kjpeng/ingestible-capsule/IngestibleCapsule-Board_larger_vias/IngestibleCapsule-Board_larger_vias.jpg

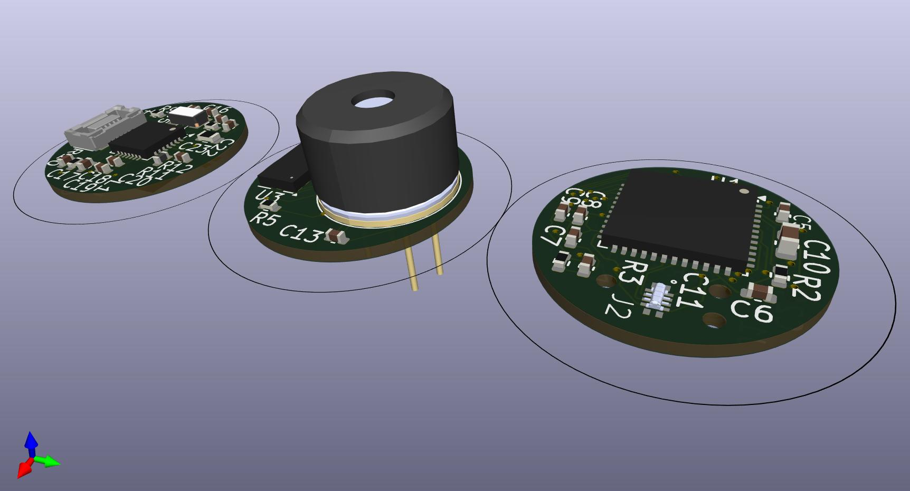
IngestibleCapsule-Board_larger_vias/IngestibleCapsule-Board_larger_vias.jpg
