kjpeng/ingestible-capsule/IngestibleCapsule-Board_v2/IngestibleCapsule-Drawing_v2.SLDPRT

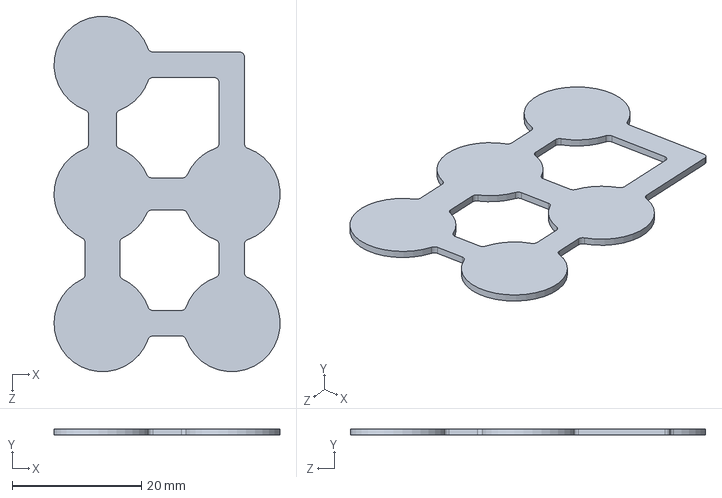
[picture p2: CAD file, 2025-04-11]
IngestibleCapsule-Board_v2/IngestibleCapsule-Drawing_v2.SLDPRT
35.0 x 1.00 x 54.9 mm
