kjpeng/ingestible-capsule/(list of files, cad)

Other CAD files:
IngestibleCapsule-Board_v2/IngestibleCapsule-Drawing_v2.DXF
