kjpeng/ingestible-capsule/IngestibleCapsule-Board_v2/IngestibleCapsule-Board_v2.kicad_pcb

## KiCad design IngestibleCapsule-Board_v2/IngestibleCapsule-Board_v2.kicad_pcb (2025-04-24)

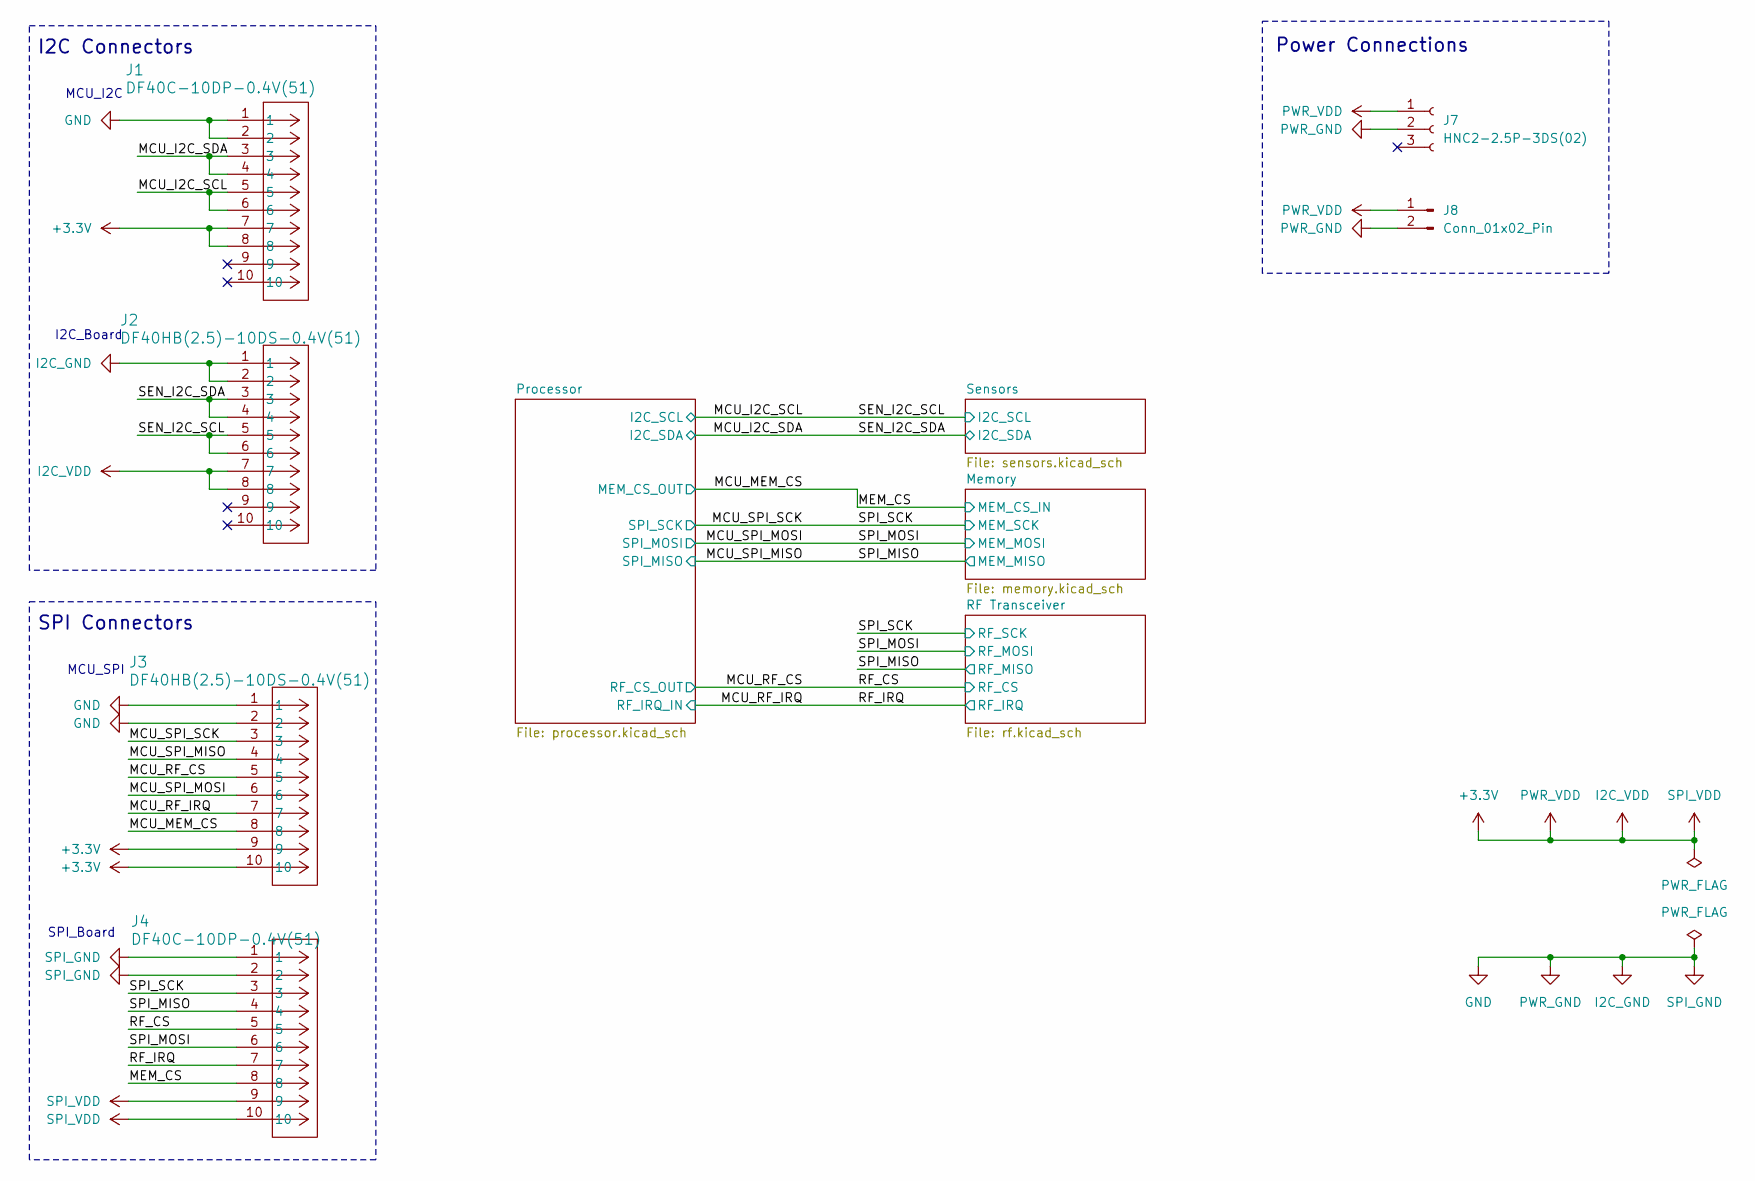
[picture p8: schematic IngestibleCapsule-Board_v2.kicad_sch, Ingestible Capsule]

Parts:
J1, J4: DF40C-10DP-0.4V(51)
J2, J3: DF40HB(2.5)-10DS-0.4V(51)
J7: HNC2-2.5P-3DS(02)
J8: Conn_01x02_Pin; PinSocket_1x02_P2.54mm_Vertical

Connections:
+3.3V: J1.7, J1.8, J2.7, J2.8, J3.9, J3.10, J4.9, J4.10, J7.1, J8.1; also elsewhere on the board
/MCU_I2C_SCL: J1.5, J1.6, J2.5, J2.6; also elsewhere on the board
/MCU_I2C_SDA: J1.3, J1.4, J2.3, J2.4; also elsewhere on the board
/MCU_MEM_CS: J3.8, J4.8; also elsewhere on the board
/MCU_RF_CS: J3.5, J4.5; also elsewhere on the board
/MCU_RF_IRQ: J3.7, J4.7; also elsewhere on the board
/MCU_SPI_MISO: J3.4, J4.4; also elsewhere on the board
/MCU_SPI_MOSI: J3.6, J4.6; also elsewhere on the board
/MCU_SPI_SCK: J3.3, J4.3; also elsewhere on the board
GND: J1.1, J1.2, J2.1, J2.2, J3.1, J3.2, J4.1, J4.2, J7.2, J8.2; also elsewhere on the board

Notes on the sheet:
MCU_I2C
I2C_Board
MCU_SPI
SPI_Board
SPI Connectors
I2C Connectors
Power Connections

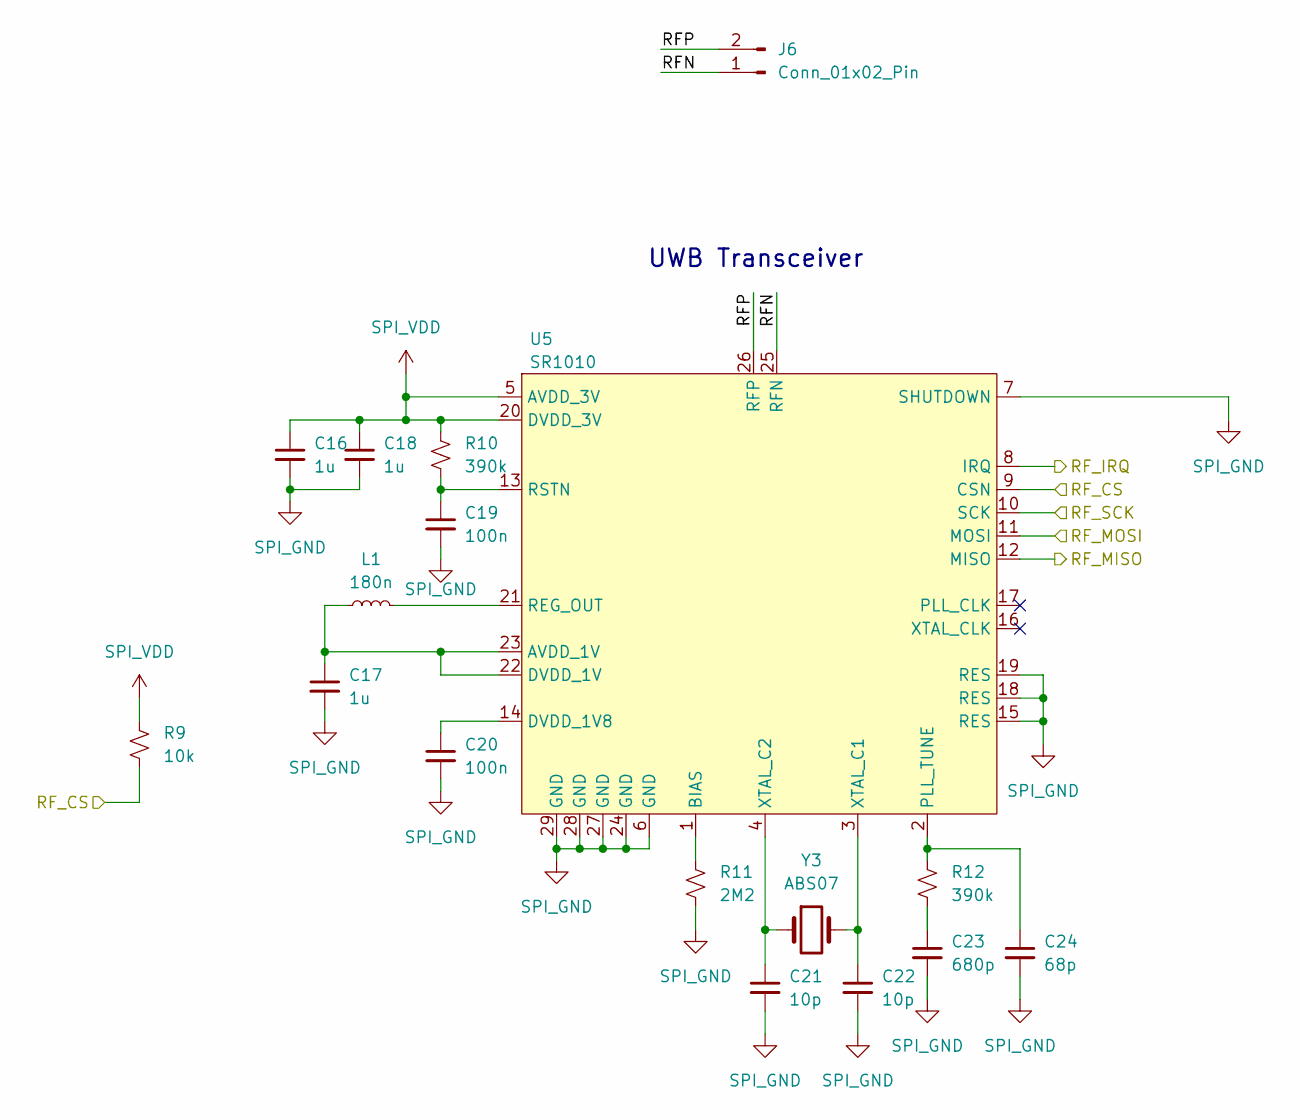
[picture p9: schematic rf.kicad_sch, RF Transceiver]

Parts:
C16, C17, C18: 1u; C_0402_1005Metric
C19, C20: 100n; C_0402_1005Metric
C21, C22: 10p; C_0402_1005Metric
C23: 680p; C_0402_1005Metric
C24: 68p; C_0402_1005Metric
J6: Conn_01x02_Pin; BM02BSRSSTBLFSN
L1: 180n; L_0402_1005Metric
R9: 10k; R_0402_1005Metric
R10, R12: 390k; R_0402_1005Metric
R11: 2M2; R_0603_1608Metric
U5: SR1010
Y3: ABS07; ABS07-120-32.768KHZ-T

Connections:
+3.3V: C16.1, C18.1, R9.1, R10.1, U5.5 (AVDD_3V), U5.20 (DVDD_3V); also elsewhere on the board
/MCU_RF_CS: R9.2, U5.9 (CSN); also elsewhere on the board
/MCU_RF_IRQ: U5.8 (IRQ); also elsewhere on the board
/MCU_SPI_MISO: U5.12 (MISO); also elsewhere on the board
/MCU_SPI_MOSI: U5.11 (MOSI); also elsewhere on the board
/MCU_SPI_SCK: U5.10 (SCK); also elsewhere on the board
/RF Transceiver/RFN: J6.1, U5.25 (RFN)
/RF Transceiver/RFP: J6.2, U5.26 (RFP)
GND: C16.2, C17.2, C18.2, C19.2, C20.2, C21.2, C22.2, C23.2, C24.2, R11.2, U5.6 (GND), U5.7 (SHUTDOWN), U5.15 (RES), U5.18 (RES), U5.19 (RES), U5.24 (GND), U5.27 (GND), U5.28 (GND), U5.29 (GND); also elsewhere on the board
unnamed: C23.1, R12.2
unnamed: C17.1, L1.1, U5.22 (DVDD_1V), U5.23 (AVDD_1V)
unnamed: R11.1, U5.1 (BIAS)
unnamed: C20.1, U5.14 (DVDD_1V8)
unnamed: C24.1, R12.1, U5.2 (PLL_TUNE)
unnamed: L1.2, U5.21 (REG_OUT)
unnamed: C19.1, R10.2, U5.13 (RSTN)
unnamed: C22.1, U5.3 (XTAL_C1), Y3.2
unnamed: C21.1, U5.4 (XTAL_C2), Y3.1

Notes on the sheet:
UWB Transceiver

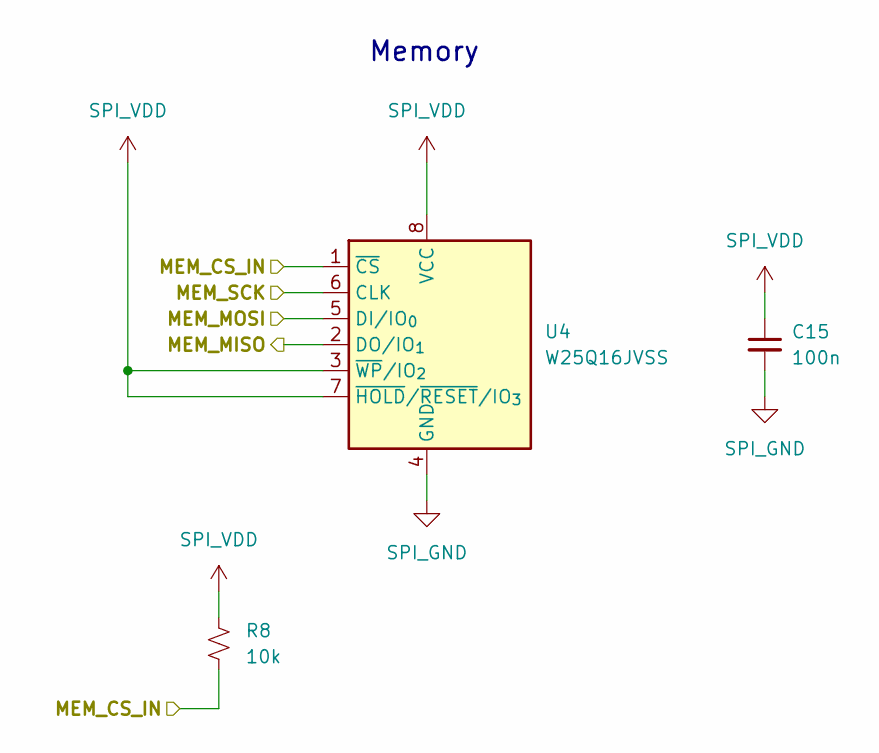
[picture p10: schematic memory.kicad_sch]

Parts:
C15: 100n; C_0402_1005Metric
R8: 10k; R_0402_1005Metric
U4: W25Q16JVSS; SOIC-8_5.3x5.3mm_P1.27mm

Connections:
+3.3V: C15.1, R8.1, U4.3 (~WP/IO_{2}), U4.7 (~HOLD/~RESET/IO_{3}), U4.8 (VCC); also elsewhere on the board
/MCU_MEM_CS: R8.2, U4.1 (~CS); also elsewhere on the board
/MCU_SPI_MISO: U4.2 (DO/IO_{1}); also elsewhere on the board
/MCU_SPI_MOSI: U4.5 (DI/IO_{0}); also elsewhere on the board
/MCU_SPI_SCK: U4.6 (CLK); also elsewhere on the board
GND: C15.2, U4.4 (GND); also elsewhere on the board

Notes on the sheet:
Memory

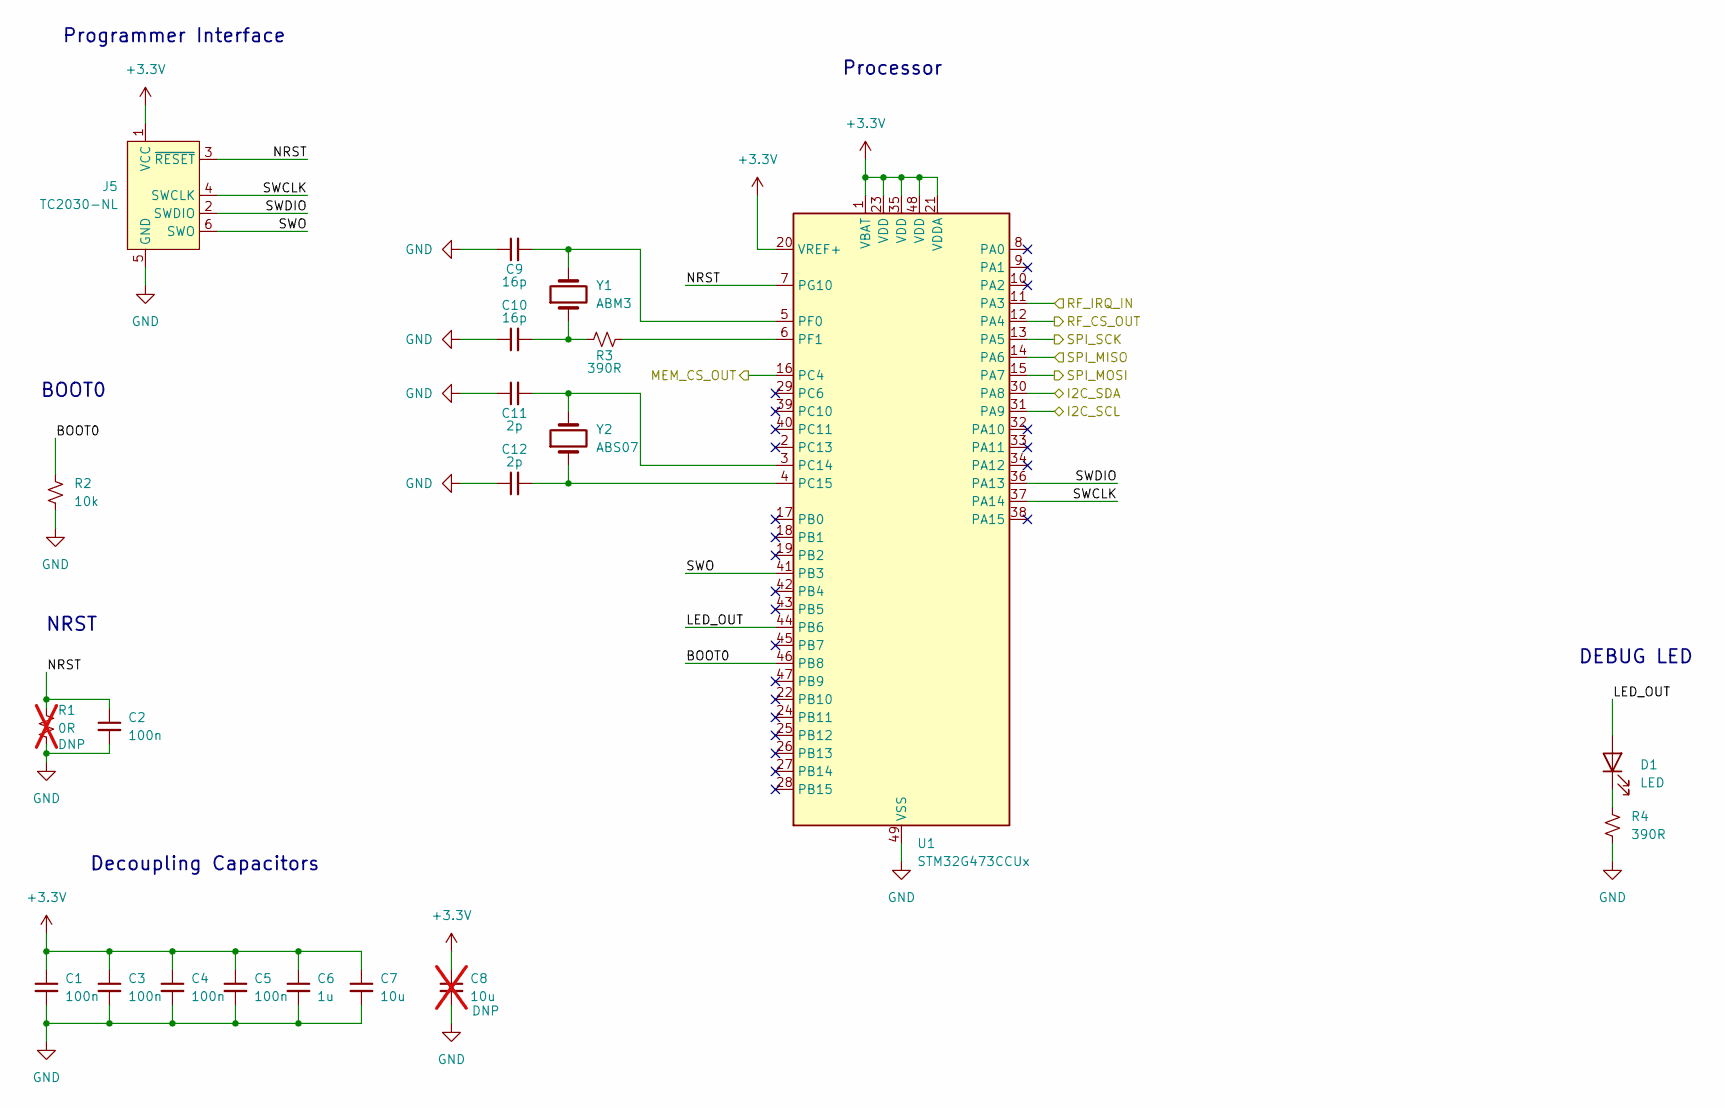
[picture p11: schematic processor.kicad_sch]

Parts:
C1, C2, C3, C4, C5: 100n; C_0402_1005Metric
C6: 1u; C_0402_1005Metric
C7: 10u; C_0603_1608Metric
C8: 10u; C_0603_1608Metric; not fitted
C9, C10: 16p; C_0402_1005Metric
C11, C12: 2p; C_0402_1005Metric
D1: LED; LED_0402_1005Metric
J5: TC2030-NL; Tag-Connect_TC2030-IDC-NL_2x03_P1.27mm_Vertical
R1: 0R; R_0402_1005Metric; not fitted
R2: 10k; R_0402_1005Metric
R3, R4: 390R; R_0402_1005Metric
U1: STM32G473CCUx; QFN-48-1EP_7x7mm_P0.5mm_EP5.6x5.6mm
Y1: ABM3; ABM3-48.000MHZ-B2-T
Y2: ABS07; ABS07-120-32.768KHZ-T

Connections:
+3.3V: C1.1, C3.1, C4.1, C5.1, C6.1, C7.1, C8.1, J5.1 (VCC), U1.1 (VBAT), U1.20 (VREF+), U1.21 (VDDA), U1.23 (VDD), U1.35 (VDD), U1.48 (VDD); also elsewhere on the board
/MCU_I2C_SCL: U1.31 (PA9); also elsewhere on the board
/MCU_I2C_SDA: U1.30 (PA8); also elsewhere on the board
/MCU_MEM_CS: U1.16 (PC4); also elsewhere on the board
/MCU_RF_CS: U1.12 (PA4); also elsewhere on the board
/MCU_RF_IRQ: U1.11 (PA3); also elsewhere on the board
/MCU_SPI_MISO: U1.14 (PA6); also elsewhere on the board
/MCU_SPI_MOSI: U1.15 (PA7); also elsewhere on the board
/MCU_SPI_SCK: U1.13 (PA5); also elsewhere on the board
/Processor/BOOT0: R2.1, U1.46 (PB8)
/Processor/LED_OUT: D1.2 (A), U1.44 (PB6)
/Processor/NRST: C2.1, J5.3 (~RESET), R1.1, U1.7 (PG10)
/Processor/SWCLK: J5.4 (SWCLK), U1.37 (PA14)
/Processor/SWDIO: J5.2 (SWDIO), U1.36 (PA13)
/Processor/SWO: J5.6 (SWO), U1.41 (PB3)
GND: C1.2, C2.2, C3.2, C4.2, C5.2, C6.2, C7.2, C8.2, C9.1, C10.1, C11.1, C12.1, J5.5 (GND), R1.2, R2.2, R4.2, U1.49 (VSS); also elsewhere on the board
unnamed: C10.2, R3.1, Y1.1
unnamed: D1.1 (K), R4.1
unnamed: C11.2, U1.3 (PC14), Y2.2
unnamed: C12.2, U1.4 (PC15), Y2.1
unnamed: C9.2, U1.5 (PF0), Y1.2
unnamed: R3.2, U1.6 (PF1)

Notes on the sheet:
Programmer Interface
Decoupling Capacitors
BOOT0
NRST
Processor
DEBUG LED

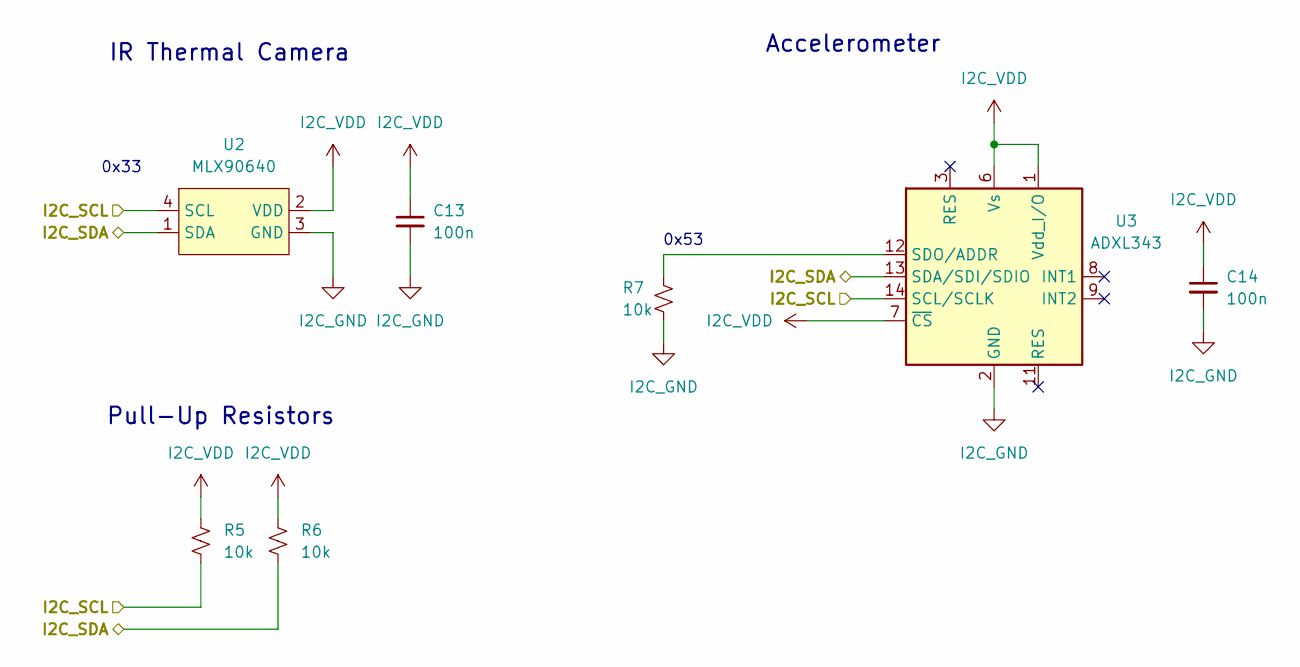
[picture p12: schematic sensors.kicad_sch]

Parts:
C13, C14: 100n; C_0402_1005Metric
R5, R6, R7: 10k; R_0402_1005Metric
U2: MLX90640
U3: ADXL343; LGA-14_3x5mm_P0.8mm_LayoutBorder1x6y

Connections:
+3.3V: C13.1, C14.1, R5.1, R6.1, U2.2 (VDD), U3.1 (Vdd_I/O), U3.6 (Vs), U3.7 (~CS); also elsewhere on the board
/MCU_I2C_SCL: R5.2, U2.4 (SCL), U3.14 (SCL/SCLK); also elsewhere on the board
/MCU_I2C_SDA: R6.2, U2.1 (SDA), U3.13 (SDA/SDI/SDIO); also elsewhere on the board
GND: C13.2, C14.2, R7.1, U2.3 (GND), U3.2 (GND), U3.4 (GND), U3.5 (GND); also elsewhere on the board
unnamed: R7.2, U3.12 (SDO/ADDR)

Notes on the sheet:
0x53
IR Thermal Camera
Accelerometer
0x33
Pull-Up Resistors

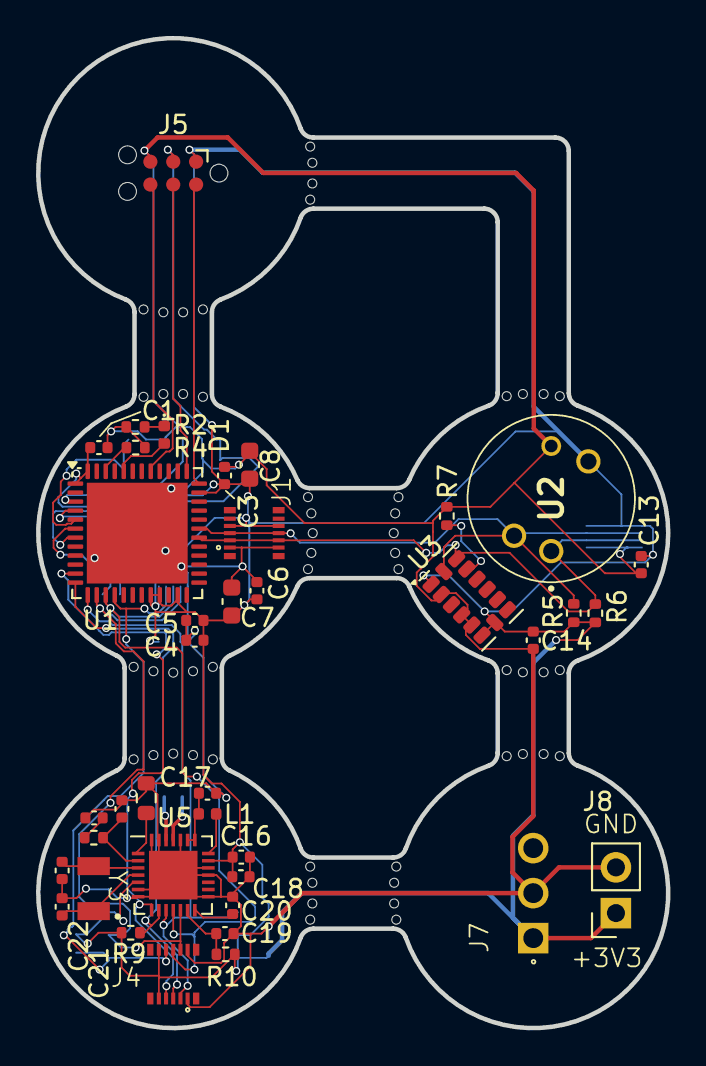
[picture p13: board IngestibleCapsule-Board_v2.kicad_pcb from above]

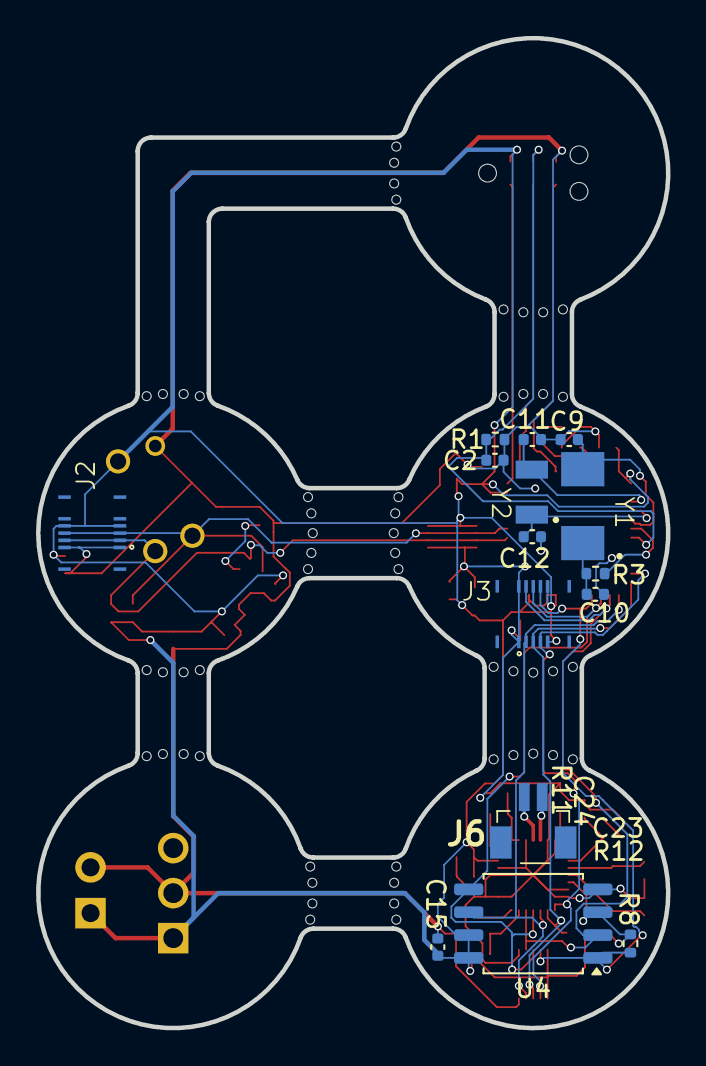
[picture p14: board IngestibleCapsule-Board_v2.kicad_pcb from below]

Board: 2 copper layers, 35.0 x 55.0 mm, 66 parts (15 on the bottom side), 34 nets.

Other parts of the board:
i2c_2_2, i2c_2_2#2: VAL**; i2c_2_2
prog_3_2, prog_3_2#2: VAL**; prog_3_2
pwr_4_2, pwr_4_2#2, pwr_4_2#3, pwr_4_2#4, pwr_4_2#5, pwr_4_2#6: VAL**; pwr_4_2
spi_4_2, spi_4_2#2: VAL**; spi_4_2
