kjpeng/ingestible-capsule/IngestibleCapsule-Board_whole/IngestibleCapsule-Board_whole.kicad_pcb

## KiCad design IngestibleCapsule-Board_whole/IngestibleCapsule-Board_whole.kicad_pcb (2025-04-24)

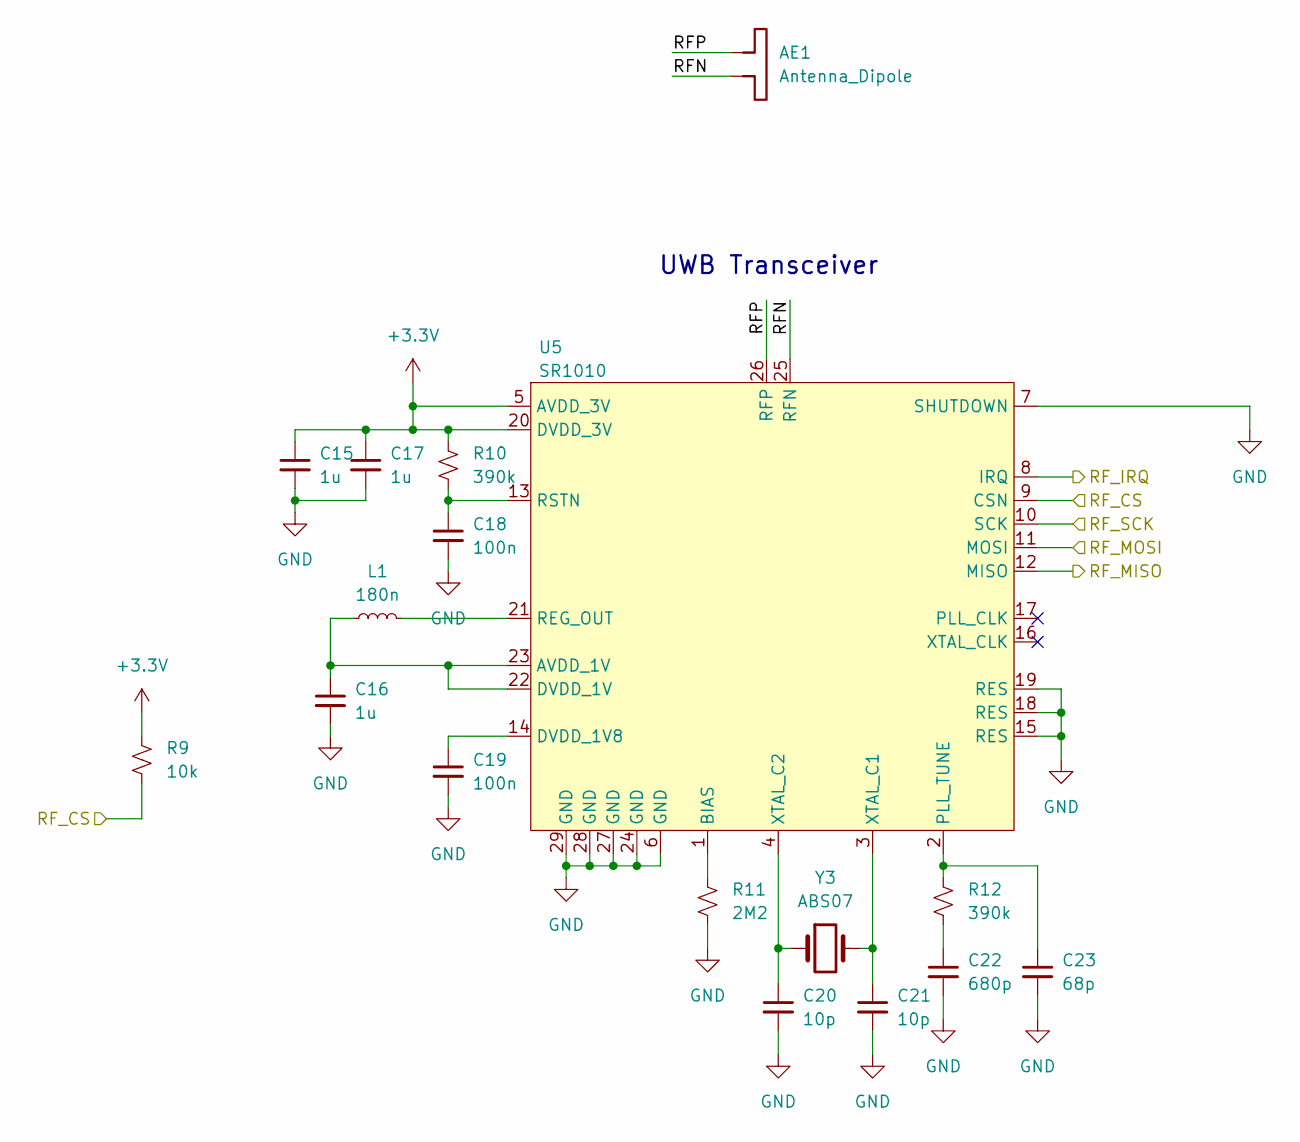
[picture p15: schematic rf.kicad_sch, RF Transceiver]

Parts:
AE1: Antenna_Dipole; Dipole Antenna
C15, C16, C17: 1u; C_0402_1005Metric
C18, C19: 100n; C_0402_1005Metric
C20, C21: 10p; C_0402_1005Metric
C22: 680p; C_0402_1005Metric
C23: 68p; C_0402_1005Metric
L1: 180n; L_0402_1005Metric
R9: 10k; R_0402_1005Metric
R10, R12: 390k; R_0402_1005Metric
R11: 2M2; R_0603_1608Metric
U5: SR1010; QFN-28-1EP_4x4mm_P0.4mm_EP2.7x2.7mm
Y3: ABS07; ABS07-120-32.768KHZ-T

Connections:
+3.3V: C15.1, C17.1, R9.1, R10.1, U5.5 (AVDD_3V), U5.20 (DVDD_3V); also elsewhere on the board
/Memory/MEM_MISO: U5.12 (MISO); also elsewhere on the board
/Memory/MEM_MOSI: U5.11 (MOSI); also elsewhere on the board
/Memory/MEM_SCK: U5.10 (SCK); also elsewhere on the board
/Processor/RF_CS_OUT: R9.2, U5.9 (CSN); also elsewhere on the board
/Processor/RF_IRQ_IN: U5.8 (IRQ); also elsewhere on the board
/RF Transceiver/RFN: AE1.2, U5.25 (RFN)
/RF Transceiver/RFP: AE1.1, U5.26 (RFP)
GND: C15.2, C16.2, C17.2, C18.2, C19.2, C20.2, C21.2, C22.2, C23.2, R11.2, U5.6 (GND), U5.7 (SHUTDOWN), U5.15 (RES), U5.18 (RES), U5.19 (RES), U5.24 (GND), U5.27 (GND), U5.28 (GND), U5.29 (GND); also elsewhere on the board
unnamed: C22.1, R12.2
unnamed: C16.1, L1.1, U5.22 (DVDD_1V), U5.23 (AVDD_1V)
unnamed: R11.1, U5.1 (BIAS)
unnamed: C19.1, U5.14 (DVDD_1V8)
unnamed: C23.1, R12.1, U5.2 (PLL_TUNE)
unnamed: L1.2, U5.21 (REG_OUT)
unnamed: C18.1, R10.2, U5.13 (RSTN)
unnamed: C21.1, U5.3 (XTAL_C1), Y3.2
unnamed: C20.1, U5.4 (XTAL_C2), Y3.1

Notes on the sheet:
UWB Transceiver

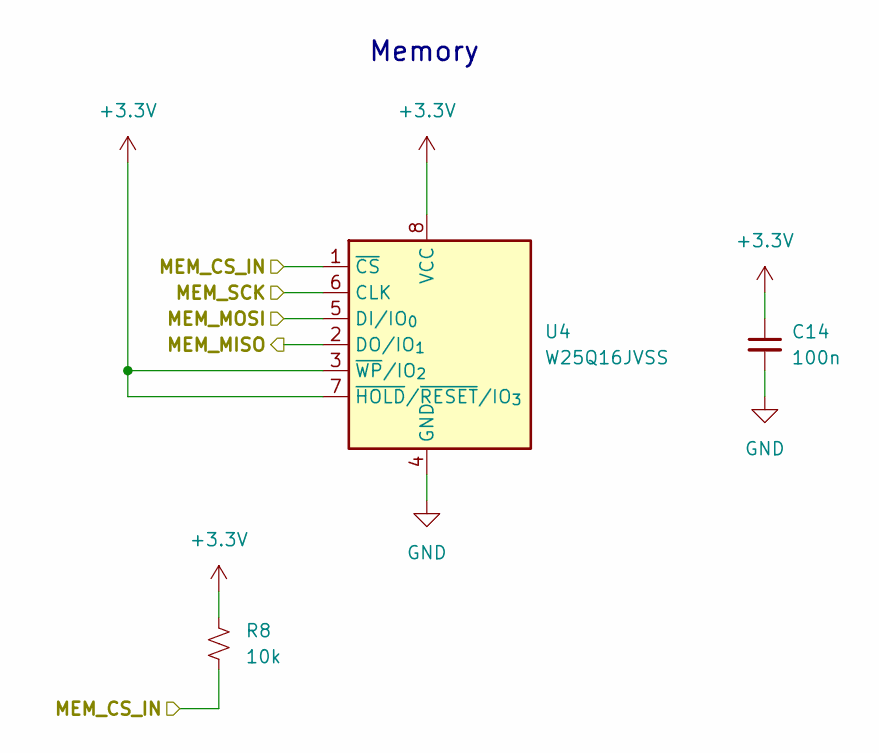
[picture p16: schematic memory.kicad_sch]

Parts:
C14: 100n; C_0402_1005Metric
R8: 10k; R_0402_1005Metric
U4: W25Q16JVSS; SOIC-8_5.3x5.3mm_P1.27mm

Connections:
+3.3V: C14.1, R8.1, U4.3 (~WP/IO_{2}), U4.7 (~HOLD/~RESET/IO_{3}), U4.8 (VCC); also elsewhere on the board
/Memory/MEM_CS_IN: R8.2, U4.1 (~CS); also elsewhere on the board
/Memory/MEM_MISO: U4.2 (DO/IO_{1}); also elsewhere on the board
/Memory/MEM_MOSI: U4.5 (DI/IO_{0}); also elsewhere on the board
/Memory/MEM_SCK: U4.6 (CLK); also elsewhere on the board
GND: C14.2, U4.4 (GND); also elsewhere on the board

Notes on the sheet:
Memory

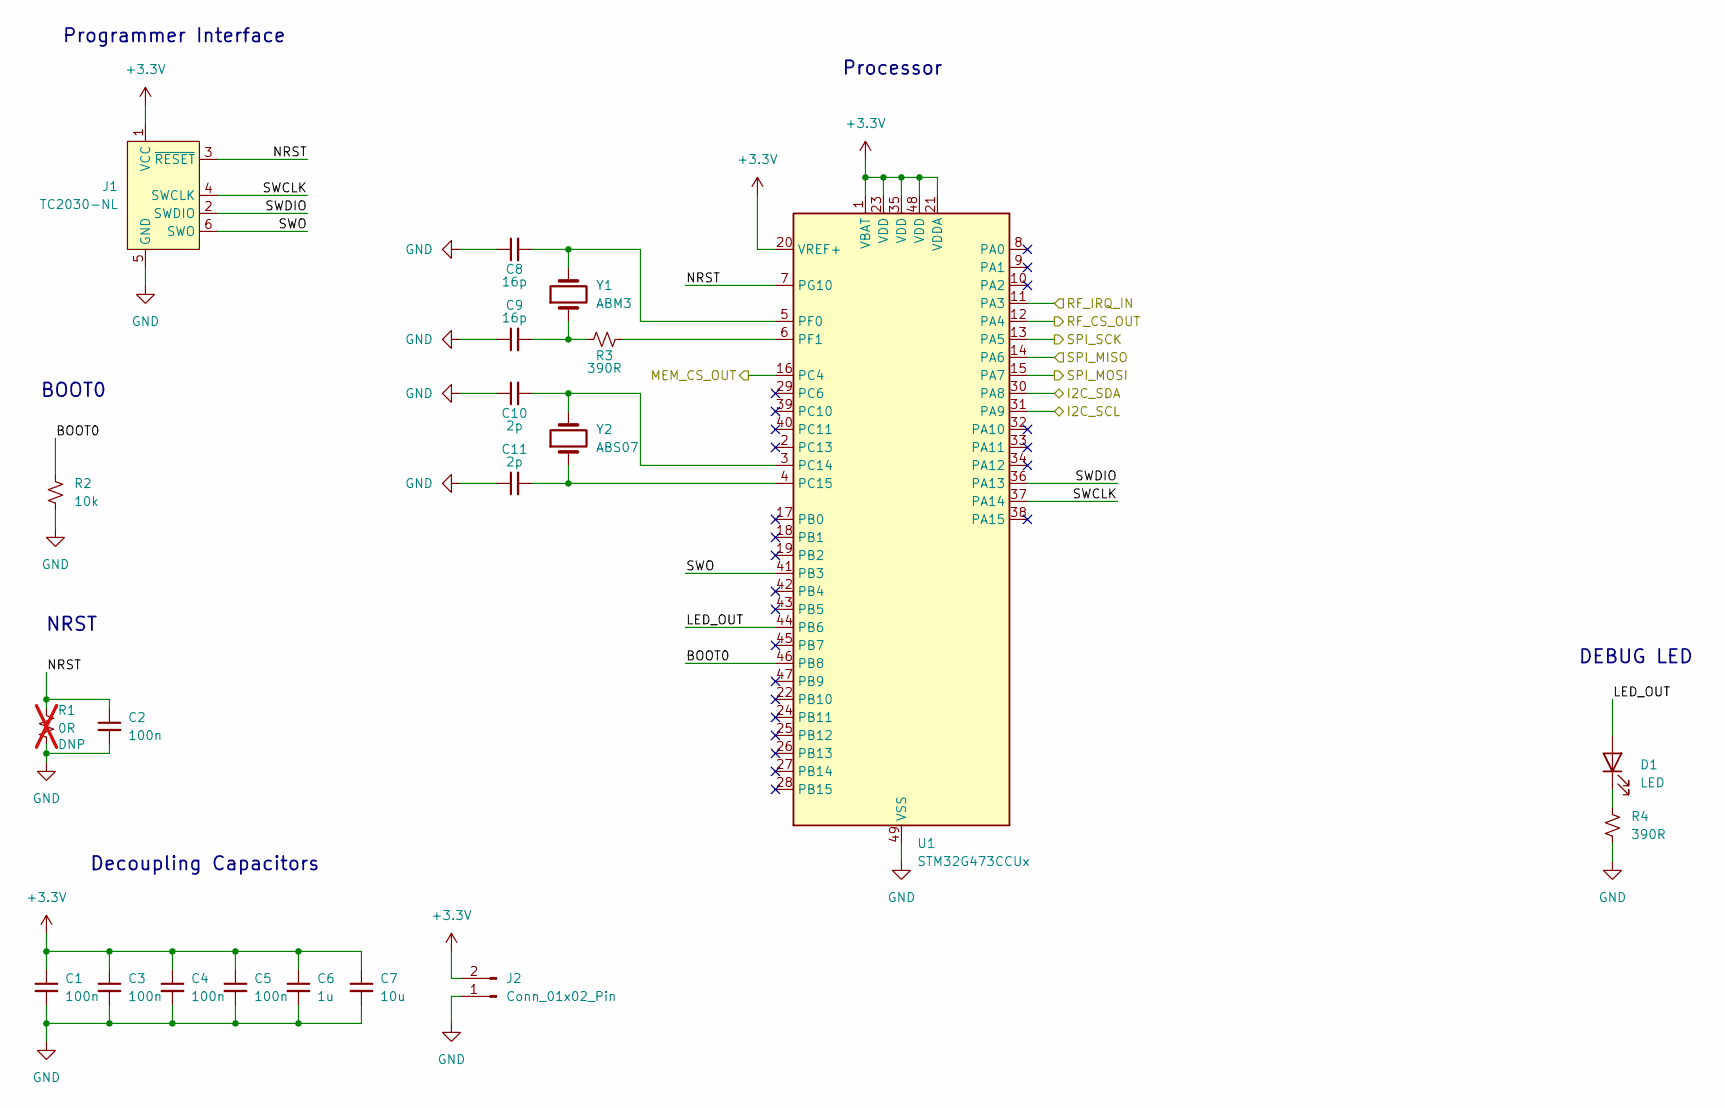
[picture p17: schematic processor.kicad_sch]

Parts:
C1, C2, C3, C4, C5: 100n; C_0402_1005Metric
C6: 1u; C_0402_1005Metric
C7: 10u; C_0603_1608Metric
C8, C9: 16p; C_0402_1005Metric
C10, C11: 2p; C_0402_1005Metric
D1: LED; LED_0402_1005Metric
J1: TC2030-NL; Tag-Connect_TC2030-IDC-NL_2x03_P1.27mm_Vertical
J2: Conn_01x02_Pin; PinHeader_1x02_P2.54mm_Vertical
R1: 0R; R_0402_1005Metric; not fitted
R2: 10k; R_0402_1005Metric
R3, R4: 390R; R_0402_1005Metric
U1: STM32G473CCUx; QFN-48-1EP_7x7mm_P0.5mm_EP5.6x5.6mm
Y1: ABM3; ABM3-48.000MHZ-B2-T
Y2: ABS07; ABS07-120-32.768KHZ-T

Connections:
+3.3V: C1.1, C3.1, C4.1, C5.1, C6.1, C7.1, J1.1 (VCC), J2.2, U1.1 (VBAT), U1.20 (VREF+), U1.21 (VDDA), U1.23 (VDD), U1.35 (VDD), U1.48 (VDD); also elsewhere on the board
/Memory/MEM_CS_IN: U1.16 (PC4); also elsewhere on the board
/Memory/MEM_MISO: U1.14 (PA6); also elsewhere on the board
/Memory/MEM_MOSI: U1.15 (PA7); also elsewhere on the board
/Memory/MEM_SCK: U1.13 (PA5); also elsewhere on the board
/Processor/BOOT0: R2.1, U1.46 (PB8)
/Processor/I2C_SCL: U1.31 (PA9); also elsewhere on the board
/Processor/I2C_SDA: U1.30 (PA8); also elsewhere on the board
/Processor/LED_OUT: D1.2 (A), U1.44 (PB6)
/Processor/NRST: C2.1, J1.3 (~RESET), R1.1, U1.7 (PG10)
/Processor/RF_CS_OUT: U1.12 (PA4); also elsewhere on the board
/Processor/RF_IRQ_IN: U1.11 (PA3); also elsewhere on the board
/Processor/SWCLK: J1.4 (SWCLK), U1.37 (PA14)
/Processor/SWDIO: J1.2 (SWDIO), U1.36 (PA13)
/Processor/SWO: J1.6 (SWO), U1.41 (PB3)
GND: C1.2, C2.2, C3.2, C4.2, C5.2, C6.2, C7.2, C8.1, C9.1, C10.1, C11.1, J1.5 (GND), J2.1, R1.2, R2.2, R4.2, U1.49 (VSS); also elsewhere on the board
unnamed: C9.2, R3.1, Y1.1
unnamed: D1.1 (K), R4.1
unnamed: C10.2, U1.3 (PC14), Y2.2
unnamed: C11.2, U1.4 (PC15), Y2.1
unnamed: C8.2, U1.5 (PF0), Y1.2
unnamed: R3.2, U1.6 (PF1)

Notes on the sheet:
Programmer Interface
Decoupling Capacitors
BOOT0
NRST
Processor
DEBUG LED

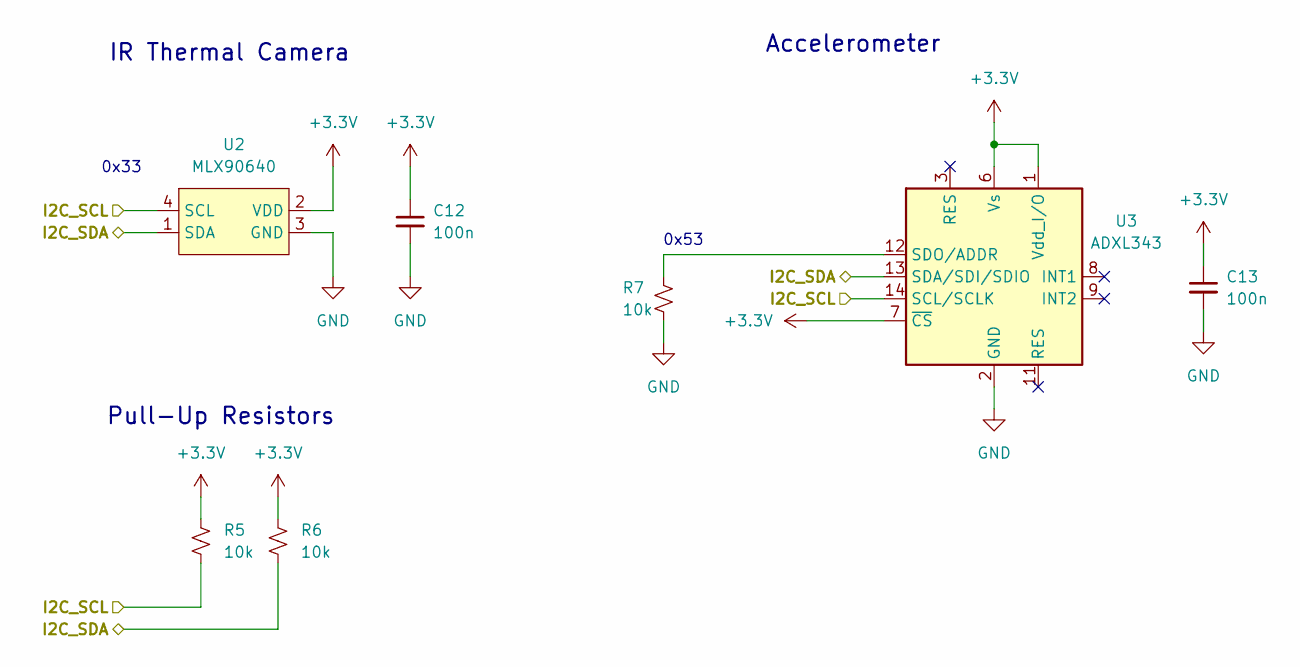
[picture p18: schematic sensors.kicad_sch]

Parts:
C12, C13: 100n; C_0402_1005Metric
R5, R6, R7: 10k; R_0402_1005Metric
U2: MLX90640
U3: ADXL343; LGA-14_3x5mm_P0.8mm_LayoutBorder1x6y

Connections:
+3.3V: C12.1, C13.1, R5.1, R6.1, U2.2 (VDD), U3.1 (Vdd_I/O), U3.6 (Vs), U3.7 (~CS); also elsewhere on the board
/Processor/I2C_SCL: R5.2, U2.4 (SCL), U3.14 (SCL/SCLK); also elsewhere on the board
/Processor/I2C_SDA: R6.2, U2.1 (SDA), U3.13 (SDA/SDI/SDIO); also elsewhere on the board
GND: C12.2, C13.2, R7.1, U2.3 (GND), U3.2 (GND), U3.4 (GND), U3.5 (GND); also elsewhere on the board
unnamed: R7.2, U3.12 (SDO/ADDR)

Notes on the sheet:
0x53
IR Thermal Camera
Accelerometer
0x33
Pull-Up Resistors

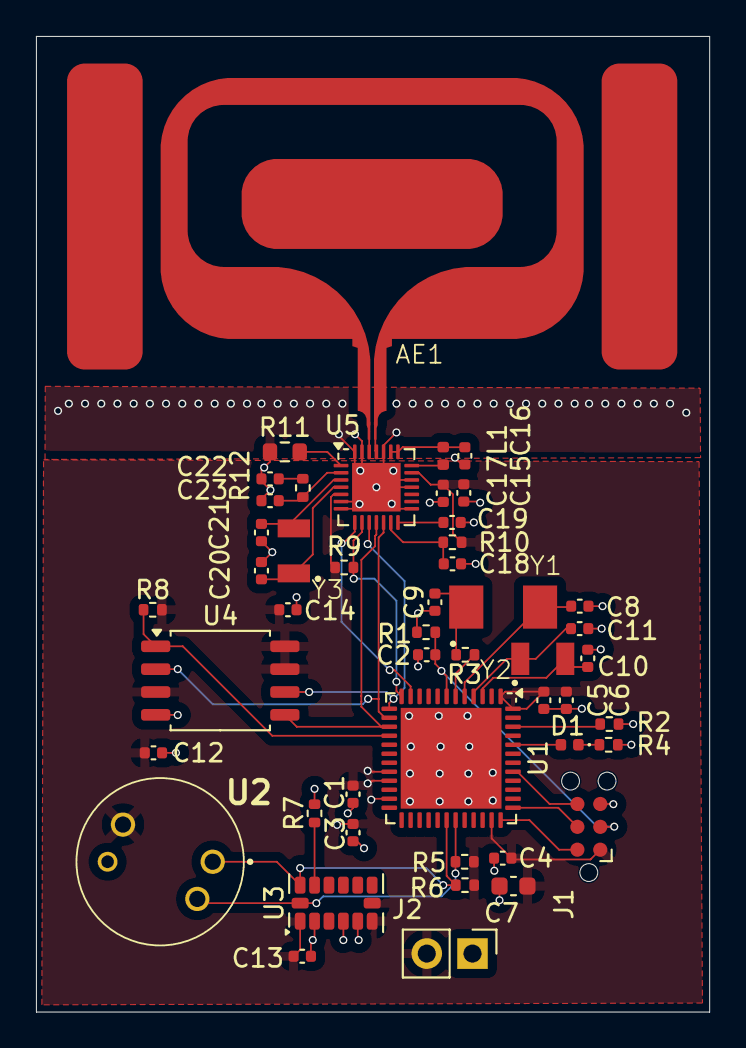
[picture p19: board IngestibleCapsule-Board_whole.kicad_pcb from above]

Board: 2 copper layers, 37.4 x 54.2 mm, 48 parts (0 on the bottom side), 34 nets.
