kjpeng/ingestible-capsule/IngestibleCapsule-Antennae/IngestibleCapsule-Antennae.kicad_pcb

## KiCad design IngestibleCapsule-Antennae/IngestibleCapsule-Antennae.kicad_pcb (2025-04-01)

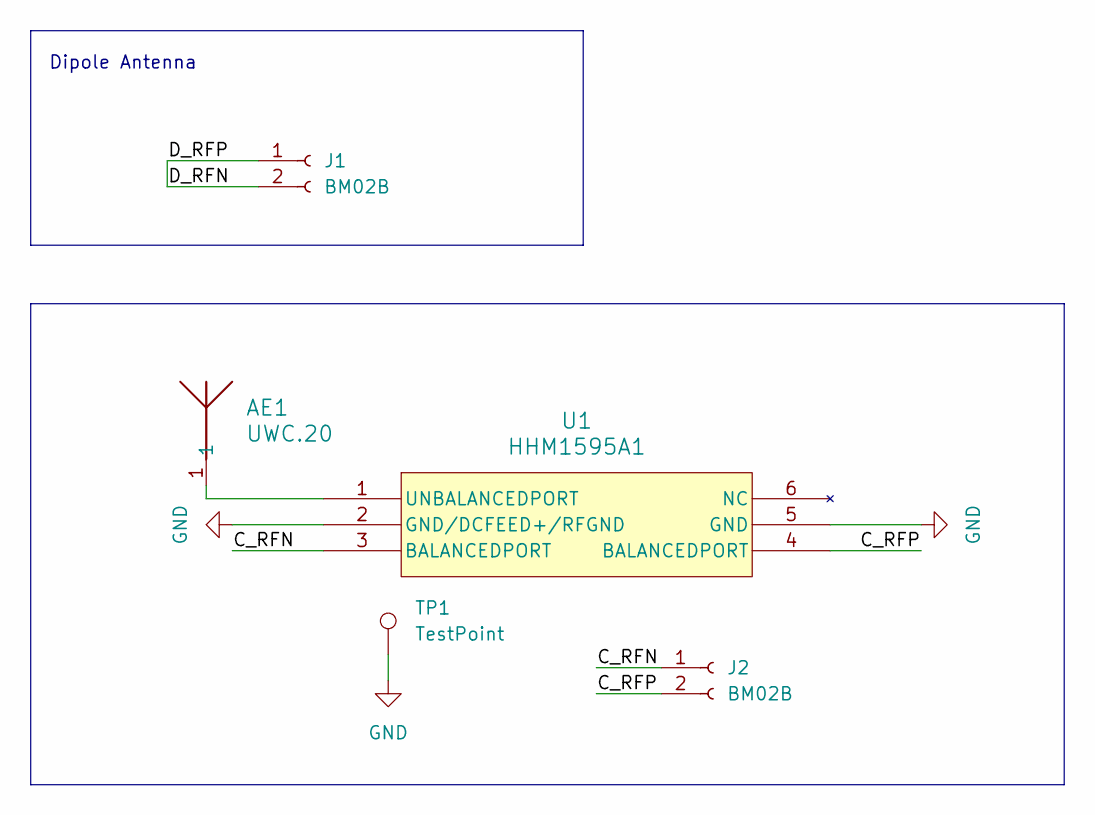
[picture p20: schematic IngestibleCapsule-Antennae.kicad_sch]

Parts:
AE1: UWC.20; ANT_SMD6_UWC_TAL
J1, J2: BM02B; BM02BSRSSTBLFSN
TP1: TestPoint; TestPoint_Pad_2.0x2.0mm
U1: HHM1595A1; HHM-6_2P0X1P25

Connections:
/C_RFN: J2.1, U1.3 (BALANCEDPORT)
/C_RFP: J2.2, U1.4 (BALANCEDPORT)
/D_RFN: J1.1, J1.2
GND: TP1.1, U1.2 (GND/DCFEED+/RFGND), U1.5 (GND)
unnamed: AE1.1, U1.1 (UNBALANCEDPORT)

Notes on the sheet:
Dipole Antenna

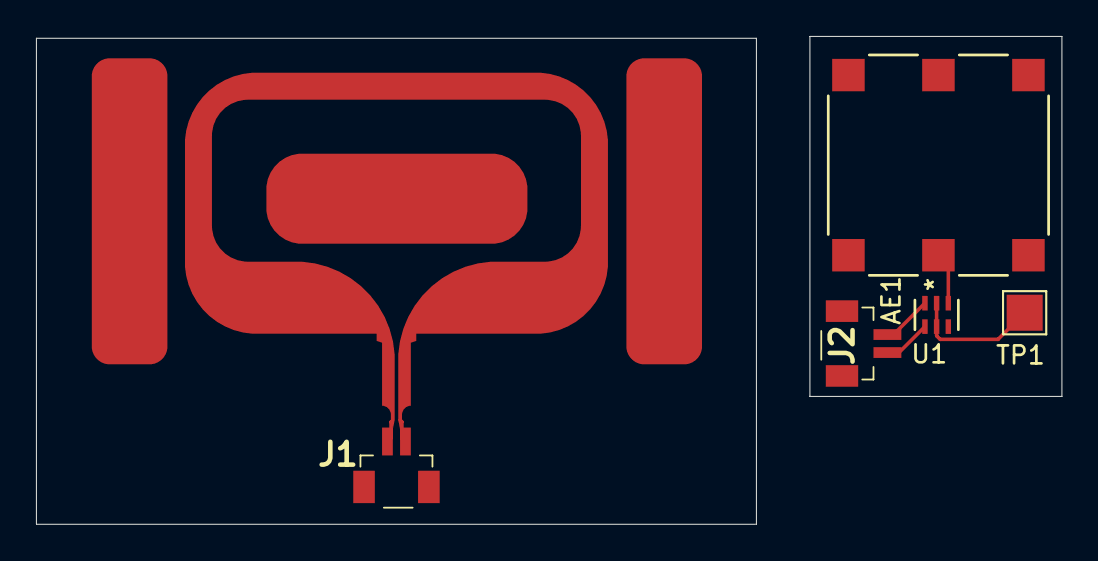
[picture p21: board IngestibleCapsule-Antennae.kicad_pcb from above]

Board: 2 copper layers, 57.0 x 27.1 mm, 5 parts (0 on the bottom side), 5 nets.
