kjpeng/ingestible-capsule/IngestibleCapsule-CubeMX/IngestibleCapsule-CubeMX.ioc

Mcu.UserName=STM32G473CCUx
PA11.Signal=GPIO_Input
PA13.Signal=SYS_JTMS-SWDIO
PA14.Signal=SYS_JTCK-SWCLK
PA3.GPIO_Label=RF_IRQ_IN
PA3.Signal=GPIO_Input
PA4.GPIO_Label=RF_CS_OUT
PA4.Signal=GPIO_Output
PA5.Signal=SPI1_SCK
PA6.Signal=SPI1_MISO
PA7.Signal=SPI1_MOSI
PA8.Signal=I2C2_SDA
PA9.Signal=I2C2_SCL
PB10.Signal=GPIO_Input
PB3.Signal=SYS_JTDO-SWO
PB6.GPIO_Label=LED_OUT
PB6.Signal=GPIO_Output
PB9.Signal=GPIO_Input
PC14-OSC32_IN.Signal=RCC_OSC32_IN
PC15-OSC32_OUT.Signal=RCC_OSC32_OUT
PC4.GPIO_Label=MEM_CS_OUT
PC4.Signal=GPIO_Output
PF0-OSC_IN.Signal=RCC_OSC_IN
PF1-OSC_OUT.Signal=RCC_OSC_OUT
