kjpeng/ingestible-capsule/BoardWhole-CubeMX/Core/Inc/main.h

#define RAD_IRQ_Pin GPIO_PIN_3
#define RAD_IRQ_GPIO_Port GPIOA
#define RAD_CS_Pin GPIO_PIN_4
#define RAD_CS_GPIO_Port GPIOA
#define MEM_CS_Pin GPIO_PIN_4
#define MEM_CS_GPIO_Port GPIOC
#define LED_Pin GPIO_PIN_6
#define LED_GPIO_Port GPIOB
