kjpeng/ingestible-capsule/(commit log)

2025-03-13 Initialize repo; first instance of full PCB
    [IngestibleCapsule-Antennae.kicad_pcb, IngestibleCapsule-Antennae.kicad_sch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]
2025-03-13 larger vias implemented
    [IngestibleCapsule-Board-B_Cu.gbr, IngestibleCapsule-Board-B_Mask.gbr, IngestibleCapsule-Board-B_Paste.gbr, IngestibleCapsule-Board-B_Silkscreen.gbr, IngestibleCapsule-Board-Edge_Cuts.gbr, IngestibleCapsule-Board-F_Cu.gbr, IngestibleCapsule-Board-F_Mask.gbr, IngestibleCapsule-Board-F_Paste.gbr]
2025-03-14 more gerbers
    [IngestibleCapsule-Antennae-B_Cu.gbr, IngestibleCapsule-Antennae-B_Mask.gbr, IngestibleCapsule-Antennae-B_Paste.gbr, IngestibleCapsule-Antennae-B_Silkscreen.gbr, IngestibleCapsule-Antennae-Edge_Cuts.gbr, IngestibleCapsule-Antennae-F_Cu.gbr, IngestibleCapsule-Antennae-F_Mask.gbr, IngestibleCapsule-Antennae-F_Paste.gbr]
2025-04-01 beginning a whole board
    [IngestibleCapsule-Antennae-B_Cu.gbr, IngestibleCapsule-Antennae-B_Mask.gbr, IngestibleCapsule-Antennae-B_Paste.gbr, IngestibleCapsule-Antennae-B_Silkscreen.gbr, IngestibleCapsule-Antennae-Edge_Cuts.gbr, IngestibleCapsule-Antennae-F_Cu.gbr, IngestibleCapsule-Antennae-F_Mask.gbr, IngestibleCapsule-Antennae-F_Paste.gbr]
2025-04-05 whole board
    [IngestibleCapsule-Board_whole-B_Cu.gbr, IngestibleCapsule-Board_whole-B_Mask.gbr, IngestibleCapsule-Board_whole-B_Paste.gbr, IngestibleCapsule-Board_whole-B_Silkscreen.gbr, IngestibleCapsule-Board_whole-Edge_Cuts.gbr, IngestibleCapsule-Board_whole-F_Cu.gbr, IngestibleCapsule-Board_whole-F_Mask.gbr, IngestibleCapsule-Board_whole-F_Paste.gbr]
2025-04-07 larger_vias fix
    [IngestibleCapsule-Board_larger_vias.kicad_pcb]
2025-04-11 v2 drawing
    [IngestibleCapsule-Drawing_v2.DXF, IngestibleCapsule-Drawing_v2.SLDPRT]
2025-04-11 restarting pcb2
    [IngestibleCapsule-Board_v2.kicad_pcb]
2025-04-11 updated drawing
    [IngestibleCapsule-Drawing_v2.DXF, IngestibleCapsule-Drawing_v2.SLDPRT]
2025-04-11 new drawing
    [IngestibleCapsule-Drawing_v2.DXF, IngestibleCapsule-Drawing_v2.SLDPRT]
2025-04-11 full v2 implementation, has 5 circles connected by mousebites
    [IngestibleCapsule-Board_v2-B_Cu.gbr, IngestibleCapsule-Board_v2-B_Mask.gbr, IngestibleCapsule-Board_v2-B_Paste.gbr, IngestibleCapsule-Board_v2-B_Silkscreen.gbr, IngestibleCapsule-Board_v2-Edge_Cuts.gbr, IngestibleCapsule-Board_v2-F_Cu.gbr, IngestibleCapsule-Board_v2-F_Mask.gbr, IngestibleCapsule-Board_v2-F_Paste.gbr]
2025-04-24 fixed spi connector orientation
    [IngestibleCapsule-Board_v2-B_Cu.gbr, IngestibleCapsule-Board_v2-B_Mask.gbr, IngestibleCapsule-Board_v2-B_Paste.gbr, IngestibleCapsule-Board_v2-B_Silkscreen.gbr, IngestibleCapsule-Board_v2-Edge_Cuts.gbr, IngestibleCapsule-Board_v2-F_Cu.gbr, IngestibleCapsule-Board_v2-F_Mask.gbr, IngestibleCapsule-Board_v2-F_Paste.gbr]
